OmarShubayr47/Atlas_SWS/academy/SmartWorkingStation_OmarShubayr/قطع المشروع/ملف المشروع.xlsx

Sheet: بيانات المشروع
ملف المشروع — أكاديمية طويق
أكاديمية طويق · إدارة التصنيع الرقمي
اسم المشروع | Smart Working Station
وصف المشروع | A projected interactive workstation: a Raspberry Pi 5 projects a user interface onto a flat work surface, a 32-inch PCAP touch foil turns that surface into a touchscreen, and a voice assistant (wake word or push-to-talk) answers through a custom Raspberry Pi 5 HAT with stereo I2S amplifiers and physical controls.
الفئة | إلكترونيات
رابط GitHub (اختياري)
رابط الفيديو (اختياري)
الدفعة | تصميم وتصنيع الحلول الهندسية V5
مقدّم الطلب أدناه هو قائد الفريق — تُنشأ باسمه صفحة المشروع.
اسم الطالب | عمر أحمد شبير
الرقم الأكاديمي | 50004
البريد الإلكتروني | omarshabir47@gmail.com
عبّي بيانات المشروع في الأعلى ثم انتقل لورقتي «الفريق» و«القطع».
الفئات المتاحة — روبوتيك · إنترنت الأشياء IoT · برمجة · إلكترونيات · طباعة ثلاثية الأبعاد · ذكاء اصطناعي · أخرى
نموذج رسمي صادر عن نظام إدارة التصنيع الرقمي — أكاديمية طويق

Sheet: الفريق
فريق المشروع
أكاديمية طويق · إدارة التصنيع الرقمي
اكتب كل أعضاء الفريق — سطر لكل عضو. مقدّم الطلب هو قائد الفريق.
العضو المسجّل مسبقاً يكفي رقمه الأكاديمي، والجديد اكتب اسمه وبريده ليُنشأ حسابه.
# | اسم العضو * | الرقم الأكاديمي | البريد الإلكتروني | الدور
1 | عمر أحمد شبير | 50004 | omarshabir47@gmail.com | قائد الفريق
2
3
4
5
6
نموذج رسمي صادر عن نظام إدارة التصنيع الرقمي — أكاديمية طويق

Sheet: القطع
قطع المشروع
أكاديمية طويق · إدارة التصنيع الرقمي
اكتب القطع المطلوبة سطراً سطراً — «Part Name (EN)» إلزامي بالإنجليزي والعدد مطلوب.
# | Part Name (EN) * | اسم القطعة | العدد | ملاحظات
1 | Raspberry Pi 5 (4 GB RAM) |  | 1 | In use. Original plan was the 8 GB model.
2 | microSD card 32 GB |  | 1 | In use. Original plan was 128 GB A2.
3 | Raspberry Pi 5 active cooler |  | 1 | Installed.
4 | USB-C power supply for Raspberry Pi 5 |  | 1 | Exact model and rating to be confirmed (plan: 27 W).
5 | Micro-HDMI to HDMI cable |  | 1 | Raspberry Pi 5 to projector.
6 | CAIWEI A12AB LED projector (1920x1080, Android 9) |  | 1 | Received and tested: native 1080p and throw ratio 1.28-1.36 measured. Its built-in speakers currently play the assistant's speech over HDMI. The ordered WiMiUS P62 Pro was not the unit received.
7 | 32-inch PCAP touch foil with ILITEK 2510 USB controller |  | 1 | Not yet tested.
8 | USB microphone (Corsair USB headset) |  | 1 | Working with the voice assistant.
9 | MAX98357AETE+T I2S Class-D amplifier IC (TQFN-16) |  | 2 | On the custom HAT, left and right channels (LCSC C910544). HAT designed, not fabricated. Current setup uses the projector speakers over HDMI; final audio choice still open.
10 | Speaker 3525/2535 cavity box, 4/8 ohm, 2/3 W |  | 2 | Left and right channels. Exact variant to be verified.
11 | Custom Raspberry Pi 5 HAT PCB |  | 1 | Designed in EasyEDA; under instructor review; not fabricated.
12 | Female 2x20 pin header 2.54 mm (40-pin) |  | 1 | Connects the HAT to the Raspberry Pi GPIO header.
13 | K6-6271D04 LED tactile switch (green) |  | 1 | AI assistant / push-to-talk button on GPIO22; LED on GPIO24 (LCSC C693824).
14 | TS365ZJ push button |  | 1 | Restart button on GPIO27 (2-second hold). Tested on the Pi (LCSC C557598).
15 | TM-001-D1-03 push button with blue LED |  | 1 | Power button wired to the Raspberry Pi 5 J2 pads; LED is a power indicator (LCSC C2884889).
16 | ALPS EC11E18244AU rotary encoder with push switch |  | 1 | Volume and mute on GPIO5/6/13 (LCSC C202365).
17 | Resistor 210 kOhm (E96, 1%) |  | 1 | R_AMP: right-amplifier channel select, 0603 (LCSC C2933168).
18 | Resistor 1 kOhm |  | 3 | R_ENC_A/B/BTN: encoder pull-ups, 0805 (LCSC C2907232).
19 | Resistor 200 Ohm |  | 2 | R_PTT_LED, R_PWR_LED: LED resistors, 0805 (LCSC C17540). Placeholder value, to be bench-verified.
20 | Capacitor 10 uF |  | 2 | Amplifier decoupling, one per IC, 0603 (LCSC C19702).
21 | Capacitor 100 nF |  | 2 | Amplifier decoupling, one per IC, 0603 (LCSC C66501).
22
23
24
25
26
27
28
29
30
31
32
33
34
35
36
37
38
39
40
نموذج رسمي صادر عن نظام إدارة التصنيع الرقمي — أكاديمية طويق
