OmarShubayr47/Atlas_SWS/academy/SmartWorkingStation_OmarShubayr/PCB/BOM/BOM_SmartWorkingStation_2026-09-27.csv

ID | Name | Designator | Footprint | Quantity | Manufacturer Part | Manufacturer | Supplier | Supplier Part | Price | Pins | Contributor | JLCPCB Part Class | Package Display | link
1 | K6-6271D04 | AI_PTT | SW-TH_K6-6271DXX | 1 | K6-6271D04 | 韩国韩荣 | LCSC | C693824 | 0.686 | 6 | lcsc | Extended Part
2 | 100nF | C1_L,C2_R | C0603 | 2 | CL10B104KO8NNNC | SAMSUNG(三星) | LCSC | C66501 | 0.009 | 2 |  | Extended Part
3 | 10uF | C1_R,C2_L | C0603 | 2 | CL10A106KP8NNNC | SAMSUNG(三星) | LCSC | C19702 | 0.032 | 2 |  | Basic Part
4 | EC11E18244AU | ENC | SW-TH_EC11XXXXXXXX | 1 | EC11E18244AU | ALPSALPINE(阿尔卑斯阿尔派) | LCSC | C202365 | 2.271 | 7 | LCSC | Extended Part
5 | MAX98357AETE+T | L_SPKR_AMP,R_SPKR_AMP | TQFN-16_L3.0-W3.0-P0.50-BL-EP1.5 | 2 | MAX98357AETE+T | ADI(亚德诺)/MAXIM(美信) | LCSC | C910544 | 1.328 | 17 | LCSC | Extended Part
6 | TM-001-D1-03 | PWR | SW-TH_TM-001-D1-04 | 1 | TM-001-D1-03 | XKB Connection(中国星坤) | LCSC | C2884889 | 0.999 | 6 | LCSC
7 | RASPBERRY PI 5 LAYOUT | RPI1 | RASPBERRYPI5-NOSILK | 1 |  | Raspberry Pi 5 4GB |  |  |  | 40 | berataksoy0 |  | No
8 | TS365ZJ | RST | KEY-TH_TS365ZJ | 1 | TS365ZJ | SHOU HAN(首韩) | LCSC | C557598 | 0.064 | 4 | LCSC | Extended Part | No
9 | 210kΩ | R_AMP | R0603 | 1 | FRC0603F2103TS | FOJAN(富捷) | LCSC | C2933168 | 0.003 | 2 | lcsc | Extended Part
10 | 1kΩ | R_ENC_A,R_ENC_B,R_ENC_BTN | R0805 | 3 | FRC0805F1001TS | FOJAN(富捷) | LCSC | C2907232 | 0.003 | 2 | erwinmargin | Extended Part |  | https://lcsc.com/eda_search?q=C2907232&%26type=1&ref=editor
11 | 200Ω | R_PTT_LED,R_PWR_LED | R0805 | 2 | 0805W8F2000T5E | UNI-ROYAL(厚声) | LCSC | C17540 | 0.007 | 2 |  | Basic Part
