OmarShubayr47/Atlas_SWS/mechanical/print_jobs/20261013/centred_stl/rack_06.stl

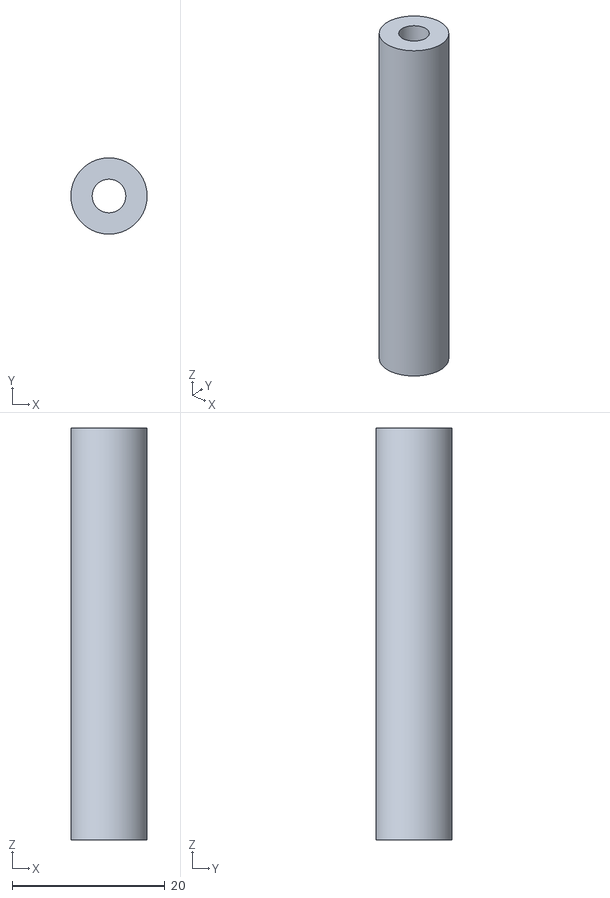
[picture p1: CAD file, 2026-10-16]
mechanical/print_jobs/20261013/centred_stl/rack_06.stl
10.0 x 10.0 x 54.0
