OmarShubayr47/Atlas_SWS/mechanical/print_jobs/20261013/centred_stl/rack_10.stl

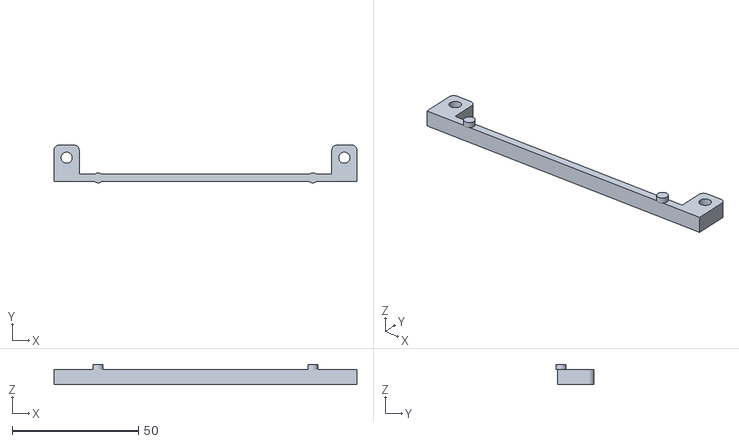
[picture p2: CAD file, 2026-10-16]
mechanical/print_jobs/20261013/centred_stl/rack_10.stl
120.0 x 15.0 x 8.00
