OmarShubayr47/Atlas_SWS/mechanical/print_jobs/20261013/centred_stl/rack_02.stl

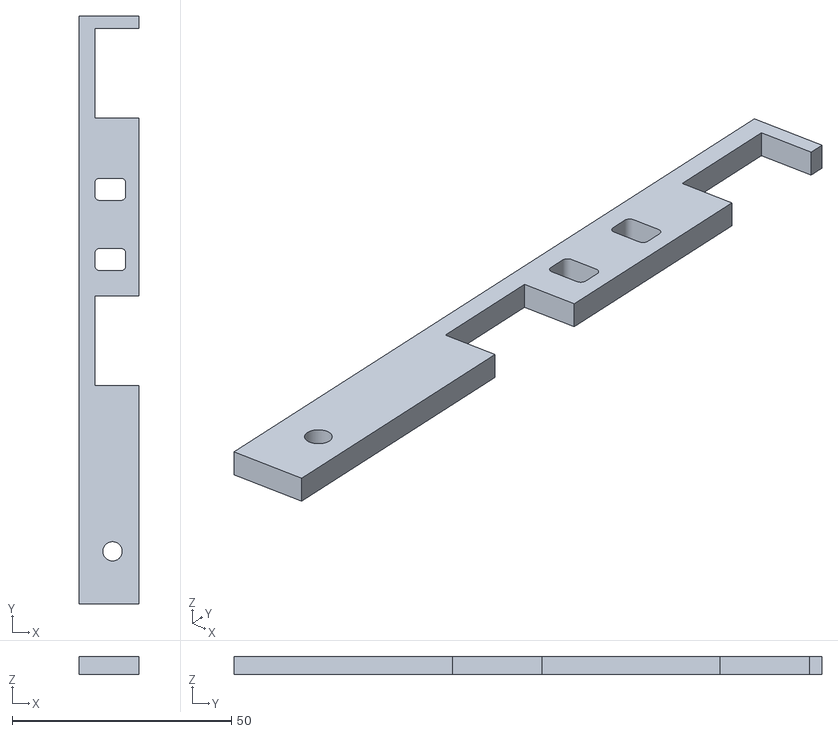
[picture p3: CAD file, 2026-10-16]
mechanical/print_jobs/20261013/centred_stl/rack_02.stl
13.6 x 134.0 x 4.20
