OmarShubayr47/Atlas_SWS/mechanical/print_jobs/20261013/centred_stl/rack_01.stl

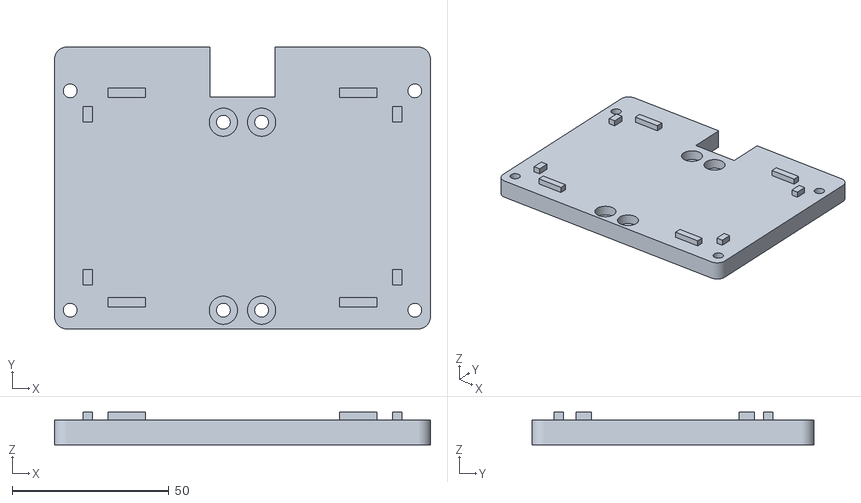
[picture p4: CAD file, 2026-10-16]
mechanical/print_jobs/20261013/centred_stl/rack_01.stl
120.0 x 90.0 x 10.5
