OmarShubayr47/Atlas_SWS/mechanical/print_jobs/20261013/centred_stl/rack_05.stl

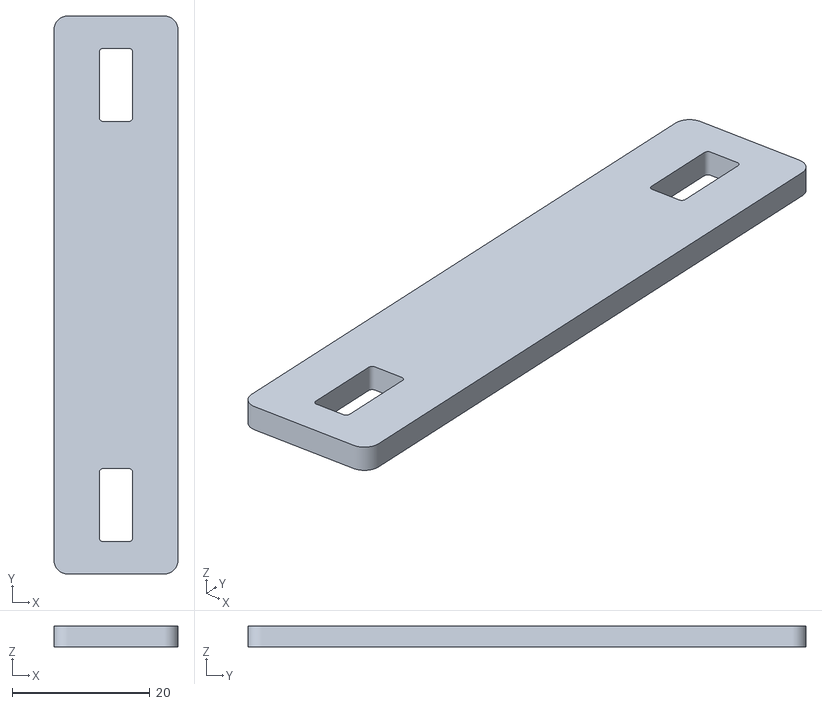
[picture p5: CAD file, 2026-10-16]
mechanical/print_jobs/20261013/centred_stl/rack_05.stl
18.0 x 81.0 x 3.00
