OmarShubayr47/Atlas_SWS/mechanical/print_jobs/20261013/centred_stl/rack_12.stl

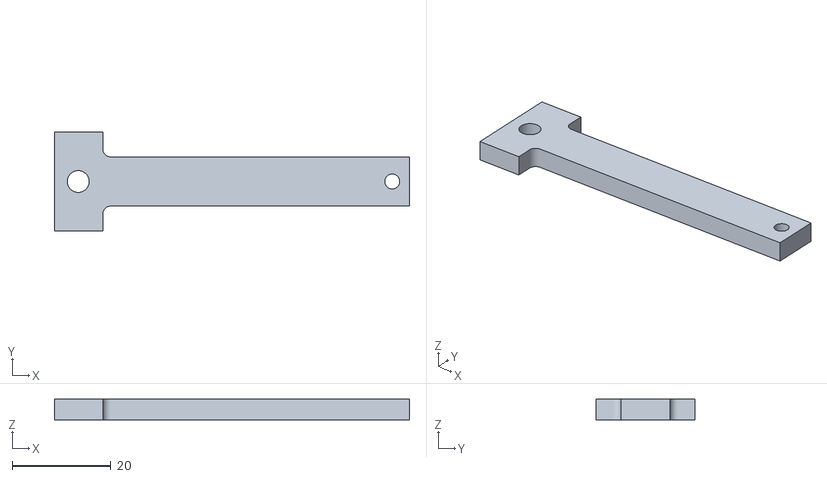
[picture p6: CAD file, 2026-10-16]
mechanical/print_jobs/20261013/centred_stl/rack_12.stl
71.8 x 20.0 x 4.20
