OmarShubayr47/Atlas_SWS/mechanical/print_jobs/20261013/centred_stl/rack_03.stl

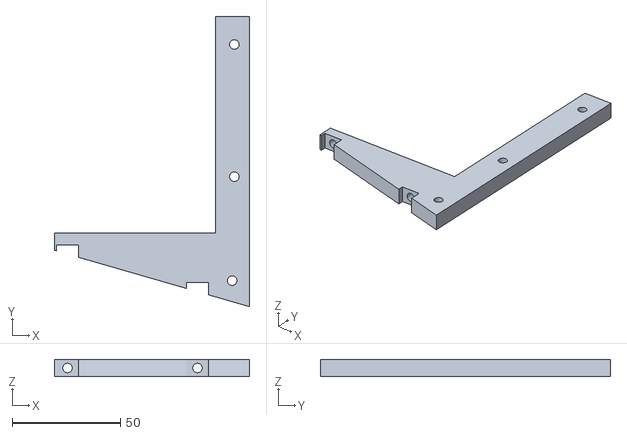
[picture p7: CAD file, 2026-10-16]
mechanical/print_jobs/20261013/centred_stl/rack_03.stl
90.0 x 134.0 x 8.00
