OmarShubayr47/Atlas_SWS/mechanical/print_jobs/20261013/centred_stl/rack_11.stl

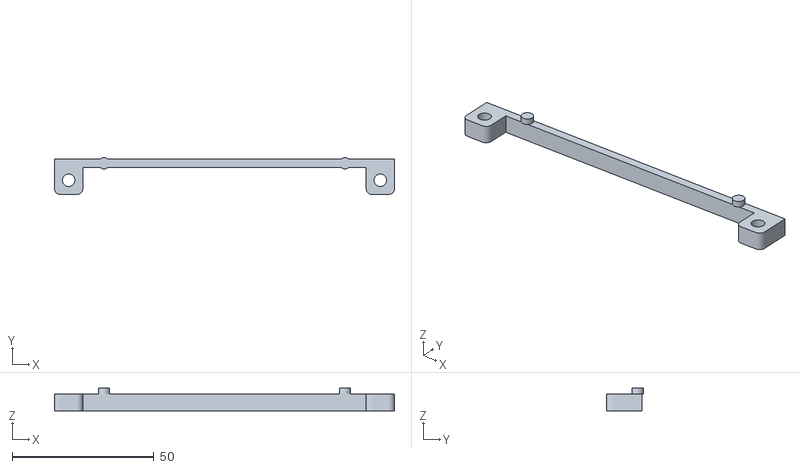
[picture p8: CAD file, 2026-10-16]
mechanical/print_jobs/20261013/centred_stl/rack_11.stl
120.0 x 13.0 x 8.00
