OmarShubayr47/Atlas_SWS/(list of files, cad)

Other CAD files:
mechanical/print_jobs/20261013/centred_stl/rack_09.stl
mechanical/print_jobs/20261013/centred_stl/rack_08.stl
mechanical/print_jobs/20261013/centred_stl/rack_13.stl
mechanical/print_jobs/20261013/centred_stl/rack_04.stl
mechanical/print_jobs/20261013/centred_stl/rack_07.stl
