OmarShubayr47/Atlas_SWS/(list of files, drawings)

Other design files:
academy/SmartWorkingStation_OmarShubayr/PCB/PCB/PCB_PCB_SmartWorkingStation_2026-09-27.json
academy/SmartWorkingStation_OmarShubayr/PCB/Schematic/SCH_SmartWorkingStation_2026-09-27.json
